karolhof/ASV-PCBs/EmisorASV/documentacion/previsualizaciones/esquema-1.png

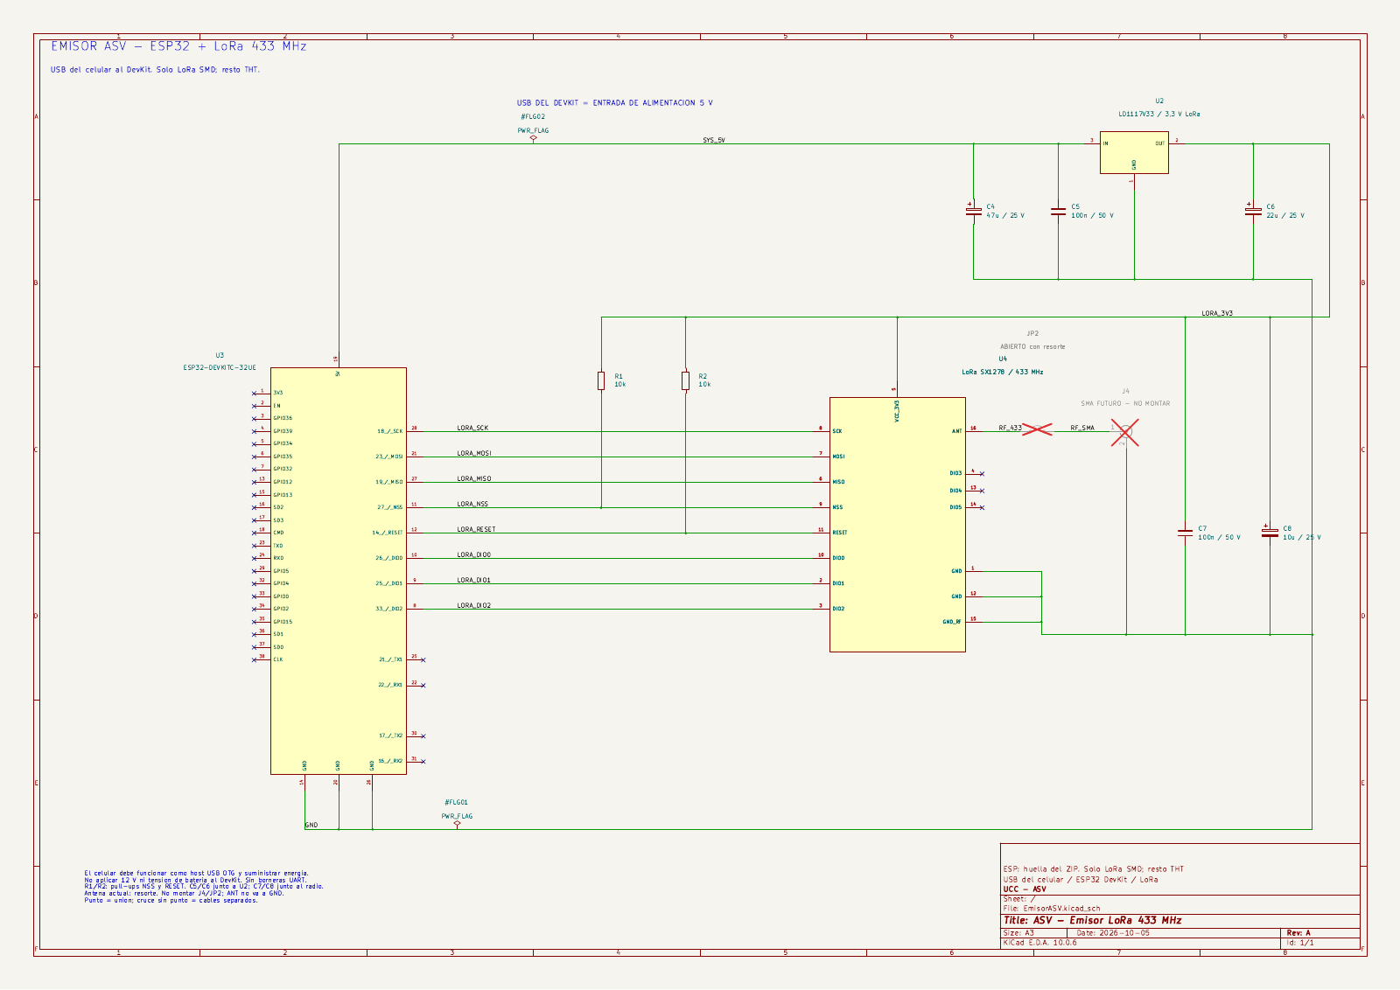
EmisorASV/documentacion/previsualizaciones/esquema-1.png
