karolhof/ASV-PCBs/EmisorASV/documentacion/previsualizaciones/impresion-1.png

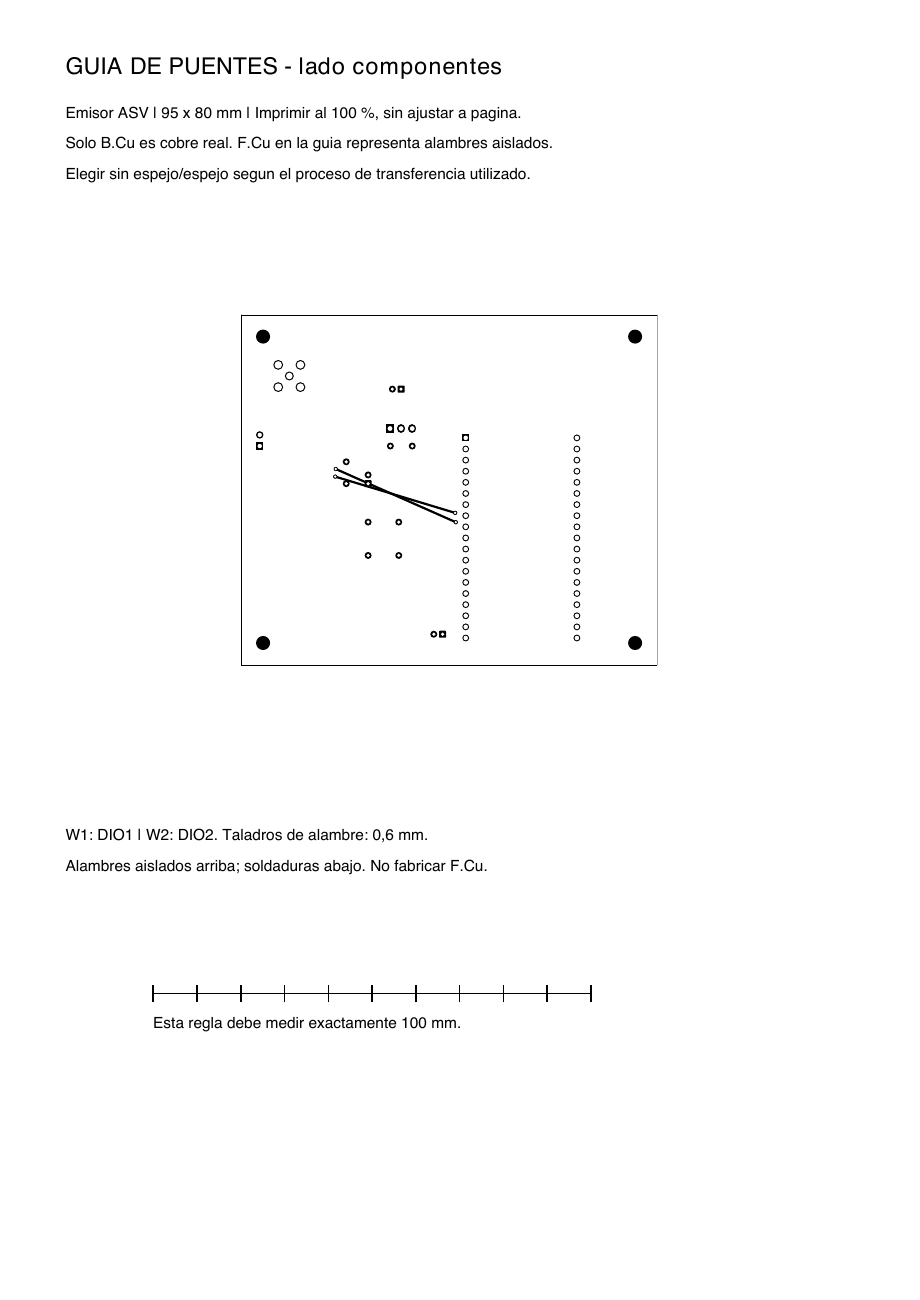
EmisorASV/documentacion/previsualizaciones/impresion-1.png
