karolhof/ASV-PCBs/EmisorASV/documentacion/previsualizaciones/impresion-2.png

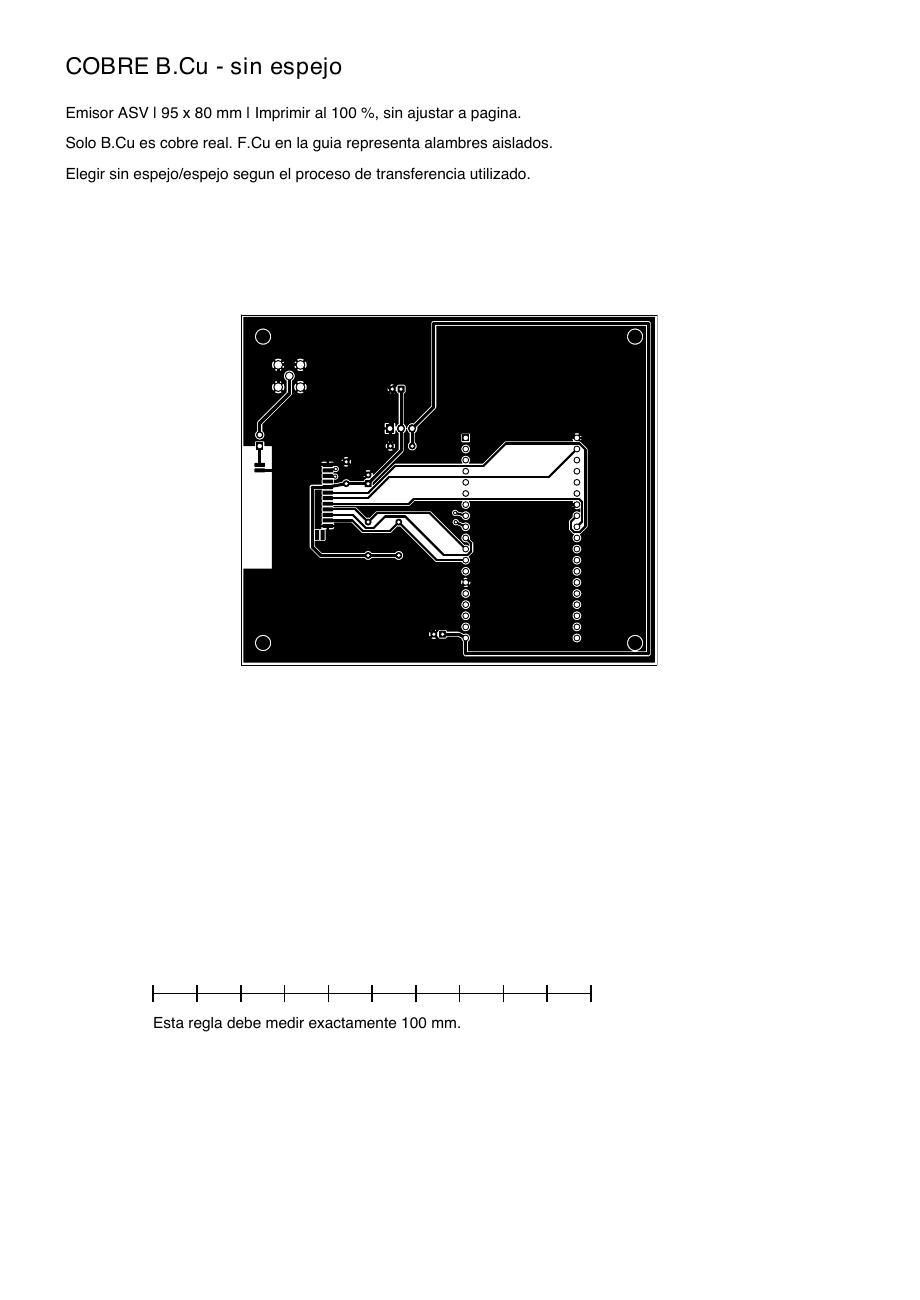
EmisorASV/documentacion/previsualizaciones/impresion-2.png
