karolhof/ASV-PCBs/EmisorASV/documentacion/previsualizaciones/impresion-3.png

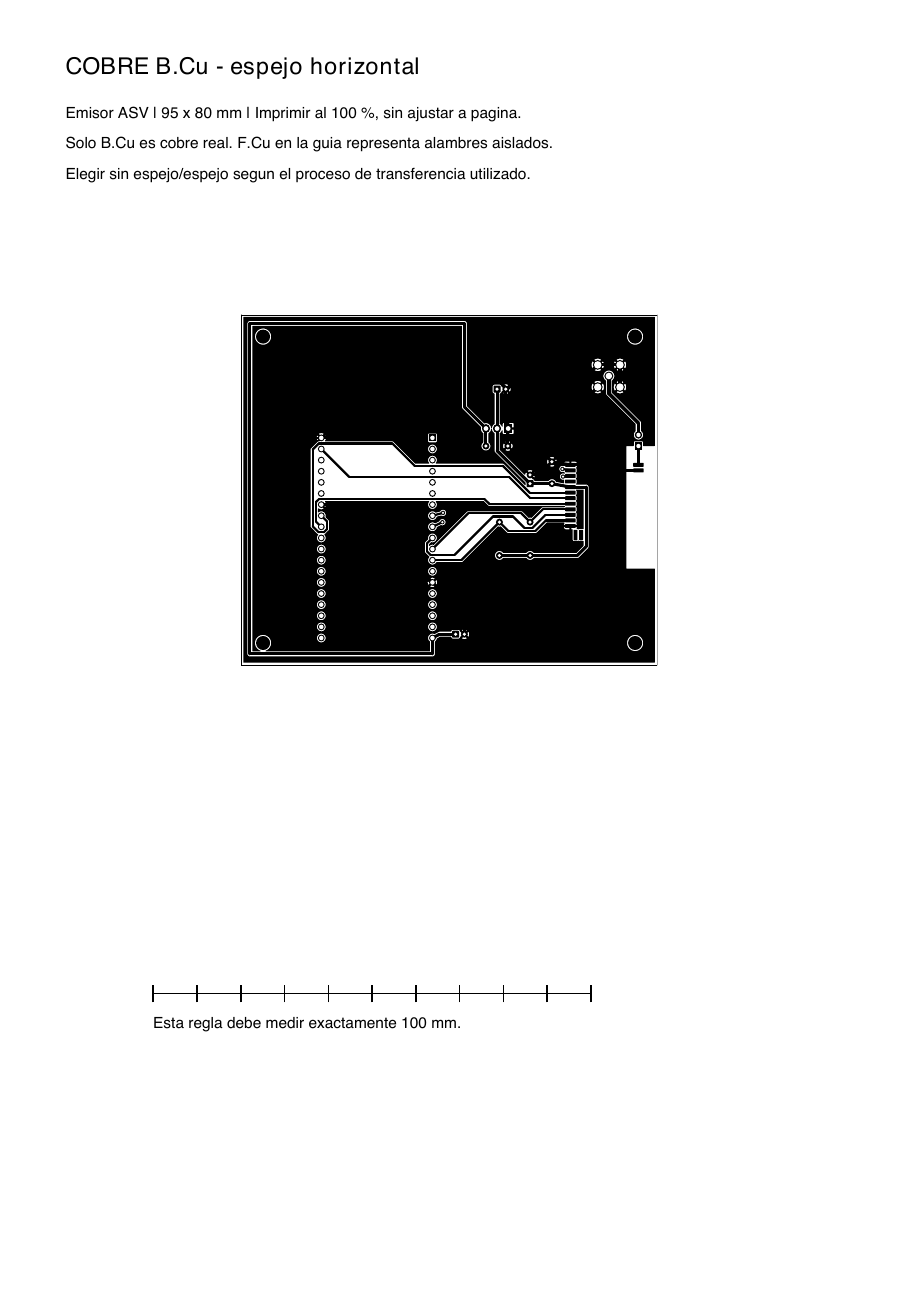
EmisorASV/documentacion/previsualizaciones/impresion-3.png
