karolhof/ASV-PCBs/ReceptorASV/documentacion/previsualizaciones/impresion-1.png

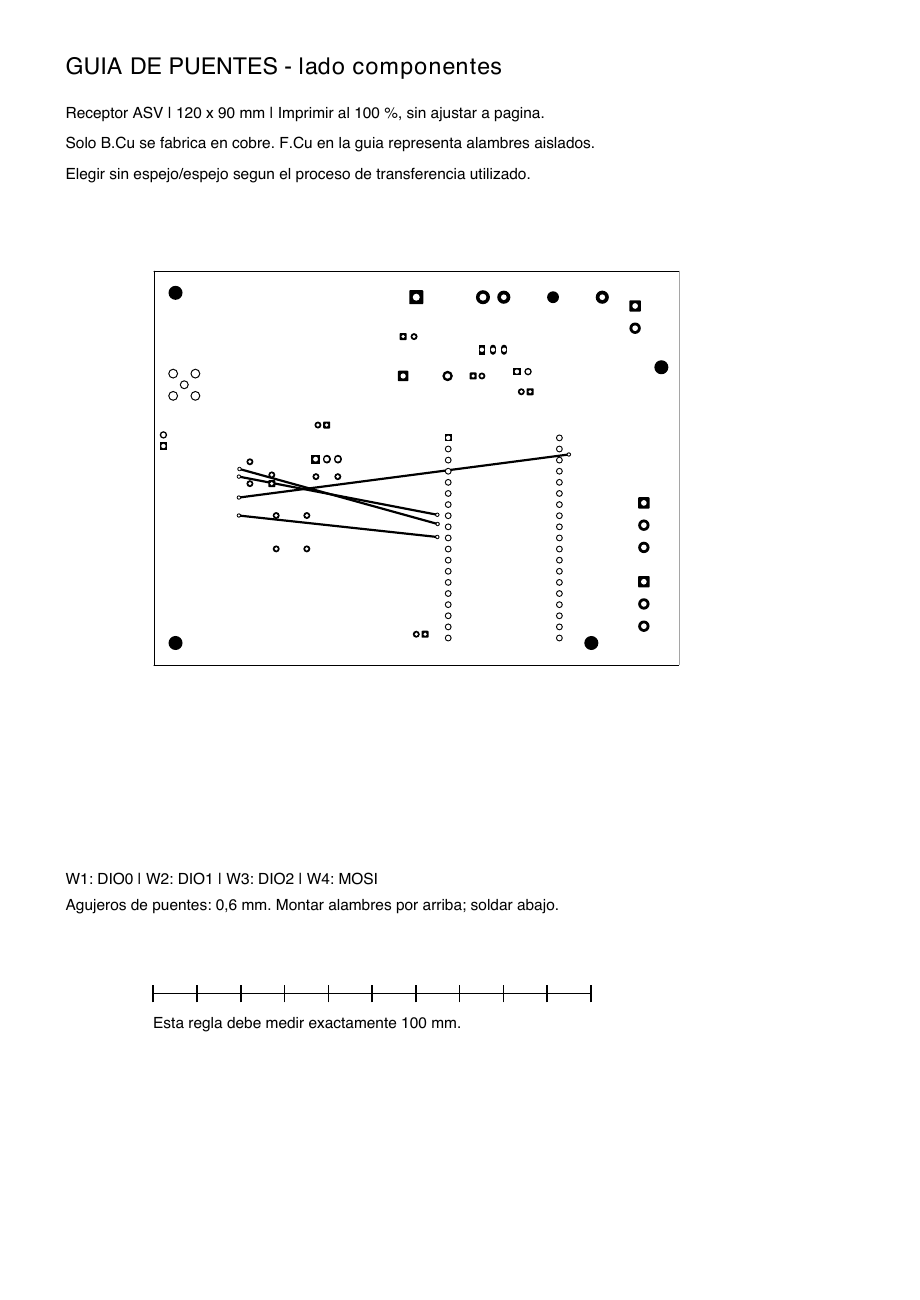
ReceptorASV/documentacion/previsualizaciones/impresion-1.png
