karolhof/ASV-PCBs/ReceptorASV/documentacion/previsualizaciones/impresion-2.png

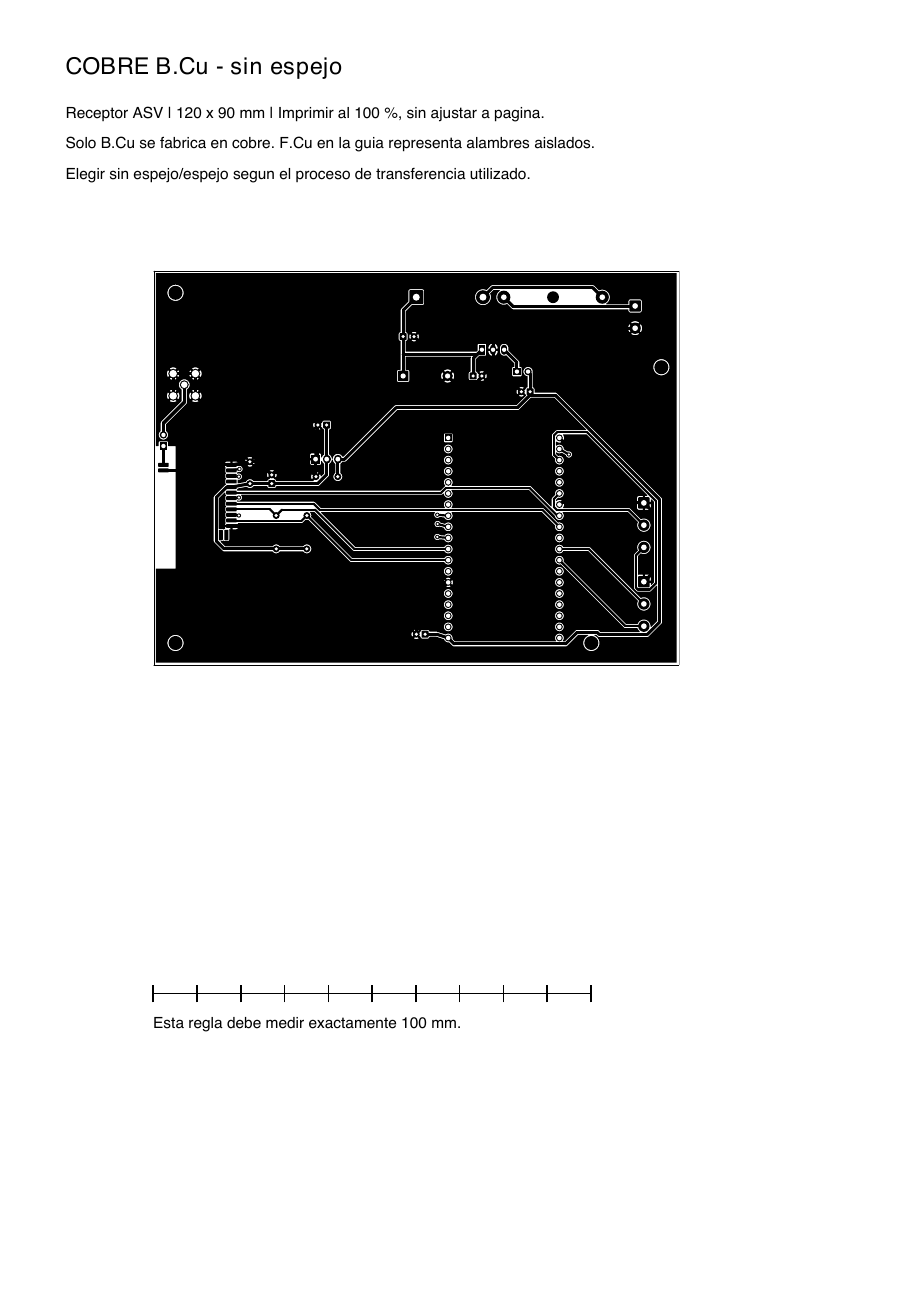
ReceptorASV/documentacion/previsualizaciones/impresion-2.png
