karolhof/ASV-PCBs/EmisorASV/documentacion/BOM.md

# BOM - Emisor ASV

| Referencia | Valor | Huella |
|---|---|---|
| U3 | ESP32-DEVKITC-32UE | ASV_Emisor:ESPRESSIF_ESP32-DEVKITC-32UE |
| U4 | LoRa SX1278 / 433 MHz | ASV_Emisor:XL1278_SMT_16P_16.5x17mm_P1.27mm |
| U2 | LD1117V33 / 3,3 V LoRa | Package_TO_SOT_THT:TO-220-3_Vertical |
| C4 | 47u / 25 V | Capacitor_THT:CP_Radial_D5.0mm_P2.00mm |
| C5 | 100n / 50 V | Capacitor_THT:C_Disc_D5.0mm_W2.5mm_P5.00mm |
| C6 | 22u / 25 V | Capacitor_THT:CP_Radial_D5.0mm_P2.00mm |
| R1 | 10k | Resistor_THT:R_Axial_DIN0207_L6.3mm_D2.5mm_P7.62mm_Horizontal |
| R2 | 10k | Resistor_THT:R_Axial_DIN0207_L6.3mm_D2.5mm_P7.62mm_Horizontal |
| J4 | SMA FUTURO - NO MONTAR | Connector_Coaxial:SMA_Amphenol_132134_Vertical |
| JP2 | ABIERTO con resorte | Connector_PinHeader_2.54mm:PinHeader_1x02_P2.54mm_Vertical |
| C7 | 100n / 50 V | Capacitor_THT:C_Disc_D5.0mm_W2.5mm_P5.00mm |
| C8 | 10u / 25 V | Capacitor_THT:CP_Radial_D5.0mm_P2.00mm |

J4/JP2 sin montar. Agregar W1/W2, dos zócalos 1×19 y cable/adaptador OTG; ver lista agrupada de materiales.
