karolhof/ASV-PCBs/EmisorASV/referencias/ESP32-DEVKITC-32UE/ESP32-DEVKITC-32UE.step

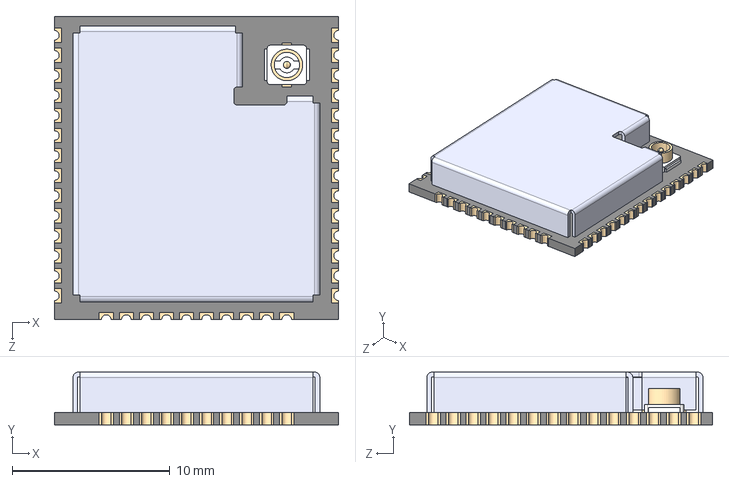
[picture p7: CAD file, 2026-10-06]
EmisorASV/referencias/ESP32-DEVKITC-32UE/ESP32-DEVKITC-32UE.step
18.0 x 3.35 x 19.2 mm
