karolhof/ASV-PCBs/EmisorASV/documentacion/previsualizaciones/montaje-1.png

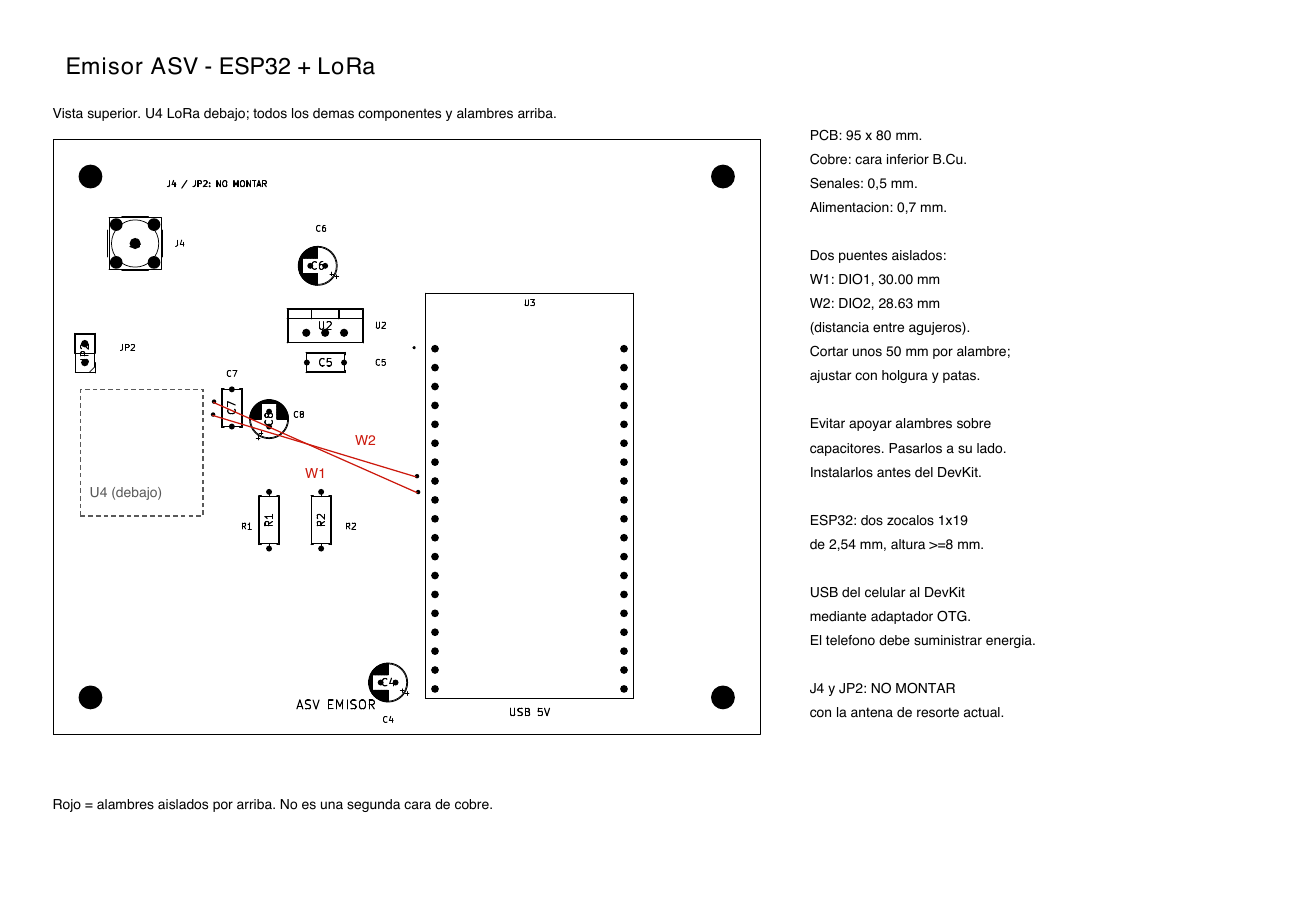
EmisorASV/documentacion/previsualizaciones/montaje-1.png
