karolhof/ASV-PCBs/EmisorASV/documentacion/previsualizaciones/montaje-2.png

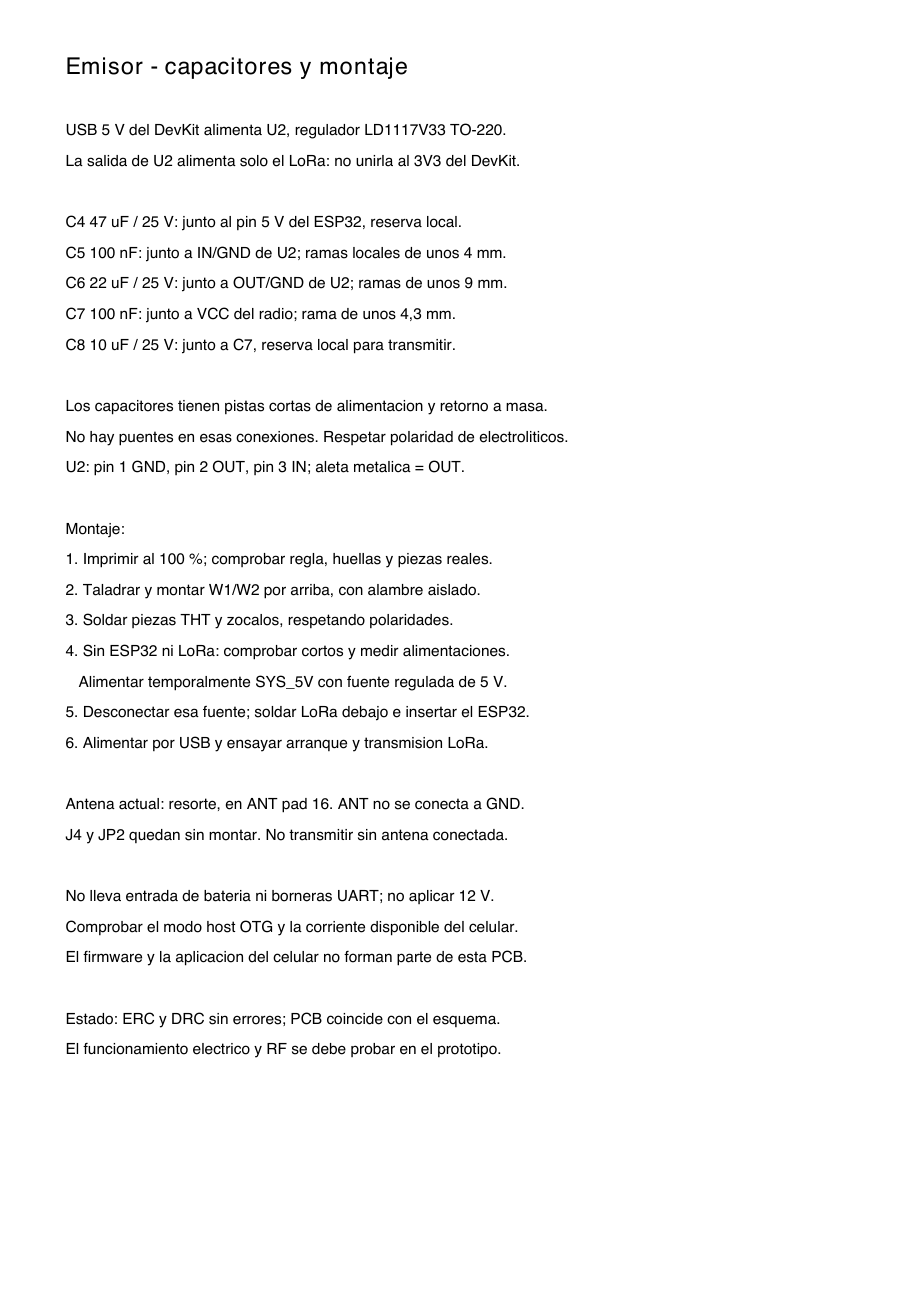
EmisorASV/documentacion/previsualizaciones/montaje-2.png
