karolhof/ASV-PCBs/ReceptorASV/documentacion/previsualizaciones/montaje-1.png

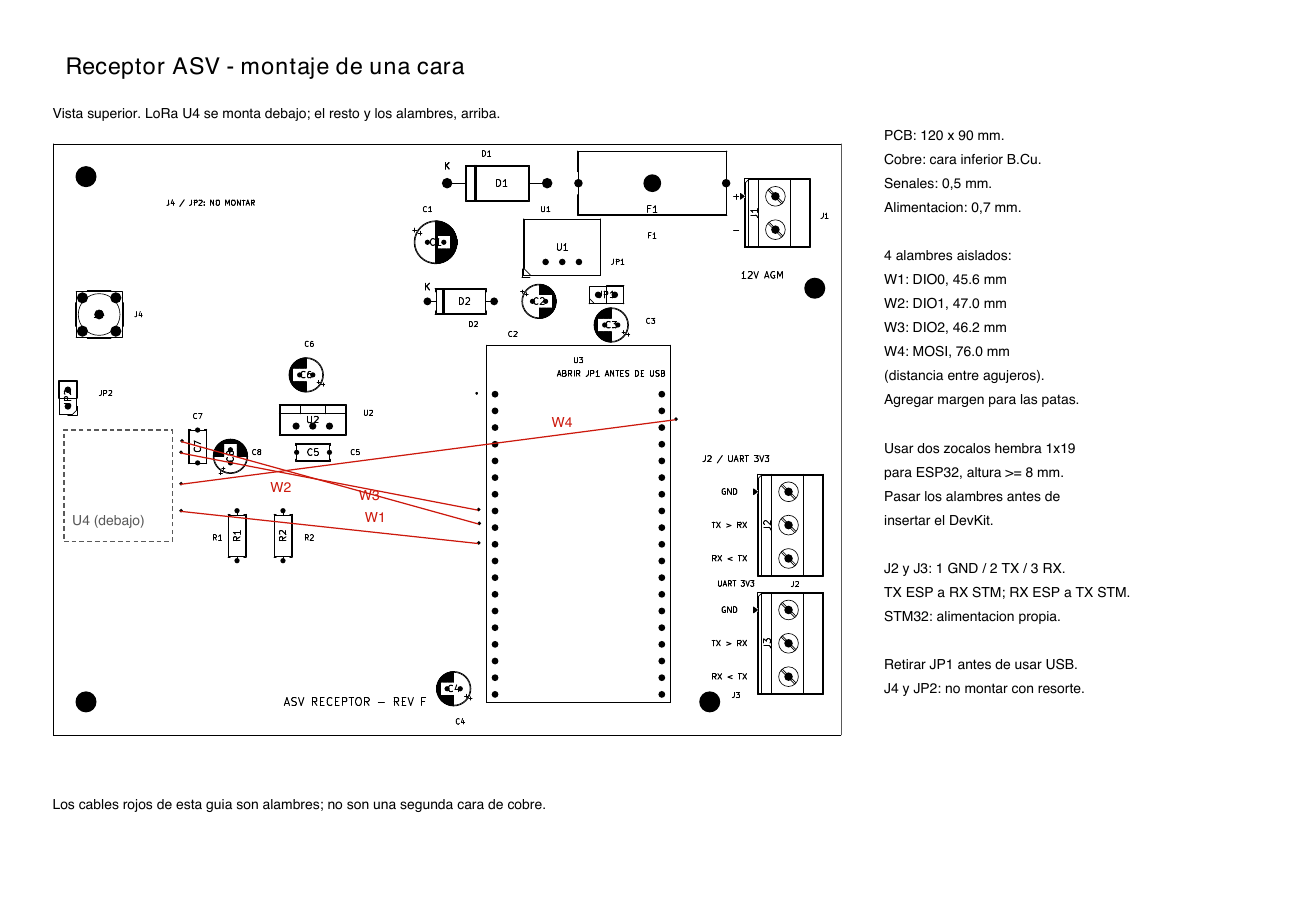
ReceptorASV/documentacion/previsualizaciones/montaje-1.png
