karolhof/ASV-PCBs/ReceptorASV/documentacion/previsualizaciones/montaje-2.png

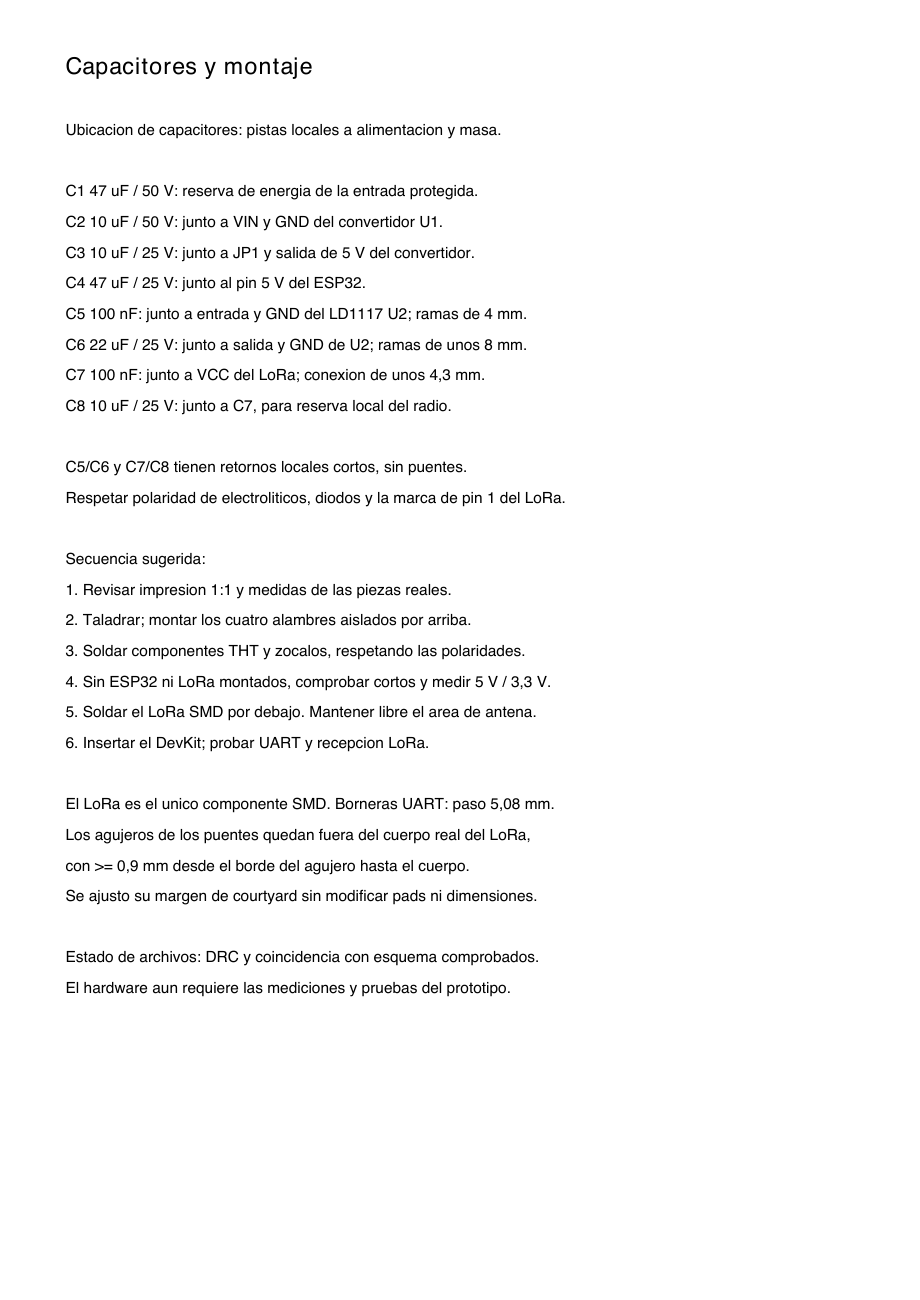
ReceptorASV/documentacion/previsualizaciones/montaje-2.png
