karolhof/ASV-PCBs/ReceptorASV/ReceptorASV.pdf

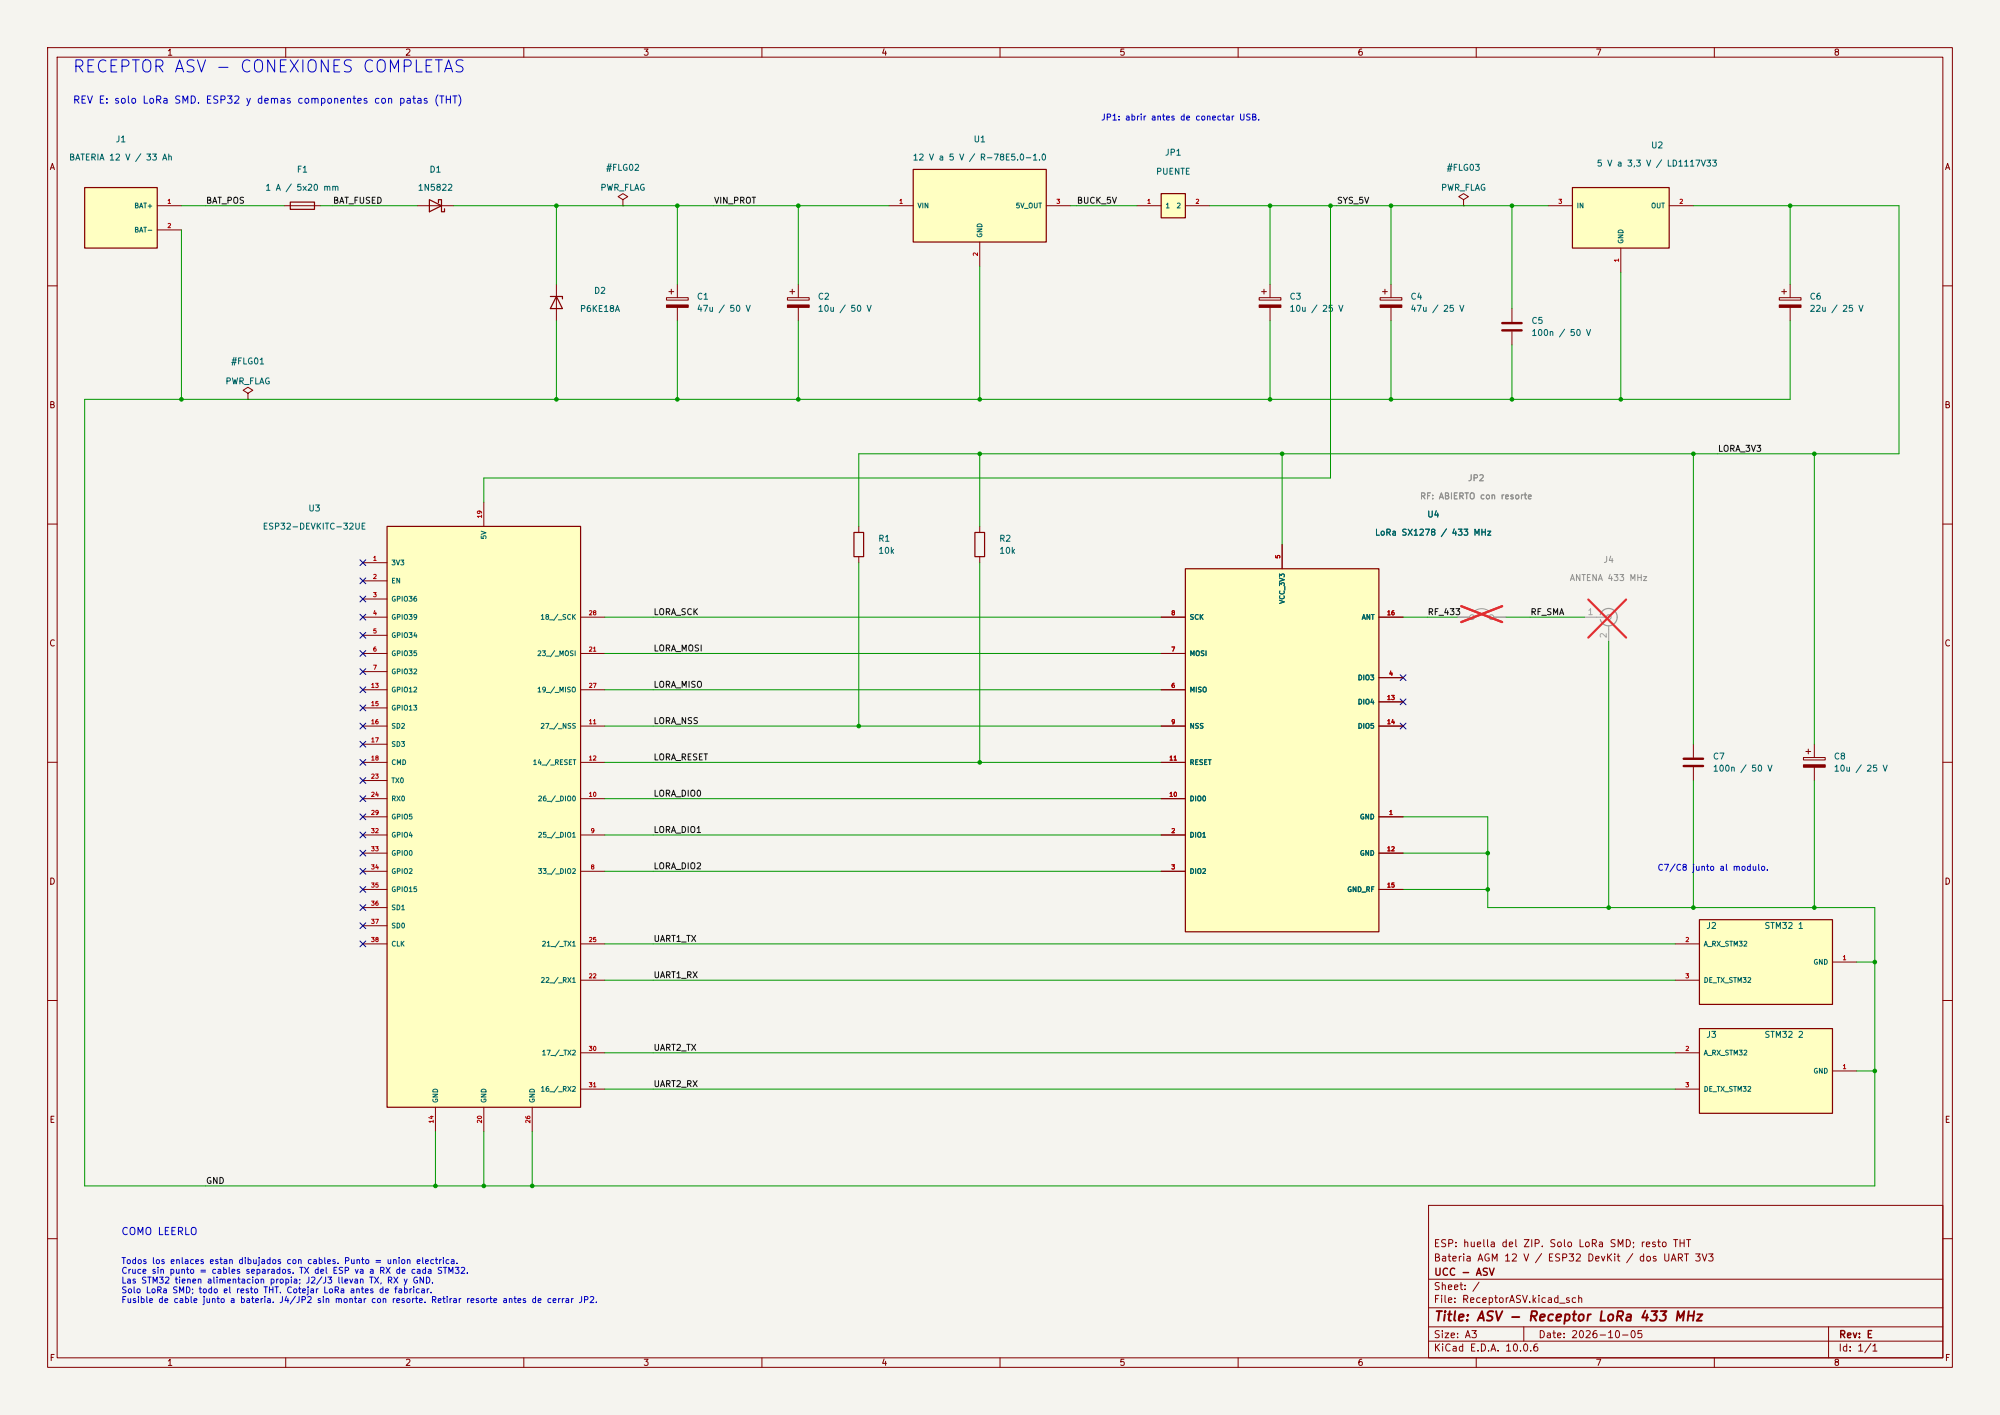
[picture p14: page 1]

RECEPTOR ASV - CONEXIONES COMPLETAS

REV E: solo LoRa SMD. ESP32 y demas componentes con patas (THT)

5 MISO 6 MOSI 7 SCK 8 NSS 9 DIO0 10 RESET 11 GND 12 DIO4 13 DIO5 14 GND_RF 15 ANT 16 JP2 RF: ABIERTO con resorte

JP2 RF: ABIERTO con resorte

5 MISO 6 MOSI 7 SCK 8 NSS 9 DIO0 10 RESET 11 GND 12 DIO4 13 DIO5 14 GND_RF 15 ANT 16 U4

ESP: huella del ZIP. Solo LoRa SMD; resto THT
Bateria AGM 12 V / ESP32 DevKit / dos UART 3V3
UCC - ASV
Sheet: /
File: ReceptorASV.kicad_sch
Title: ASV - Receptor LoRa 433 MHz

Todos los enlaces estan dibujados con cables. Punto = union electrica. Cruce sin punto = cables separados. TX del ESP va a RX de cada STM32. Las STM32 tienen alimentacion propia; J2/J3 llevan TX, RX y GND. Solo LoRa SMD; todo el resto THT. Cotejar LoRa antes de fabricar. Fusible de cable junto a bateria. J4/JP2 sin montar con resorte. Retirar resorte antes de cerrar JP2.

Size: A3 | Rev: E | F Date: 2026-10-05
KiCad E.D.A. 10.0.6 | Id: 1/1
