karolhof/ASV-PCBs/EmisorASV/documentacion/EmisorASV.pdf

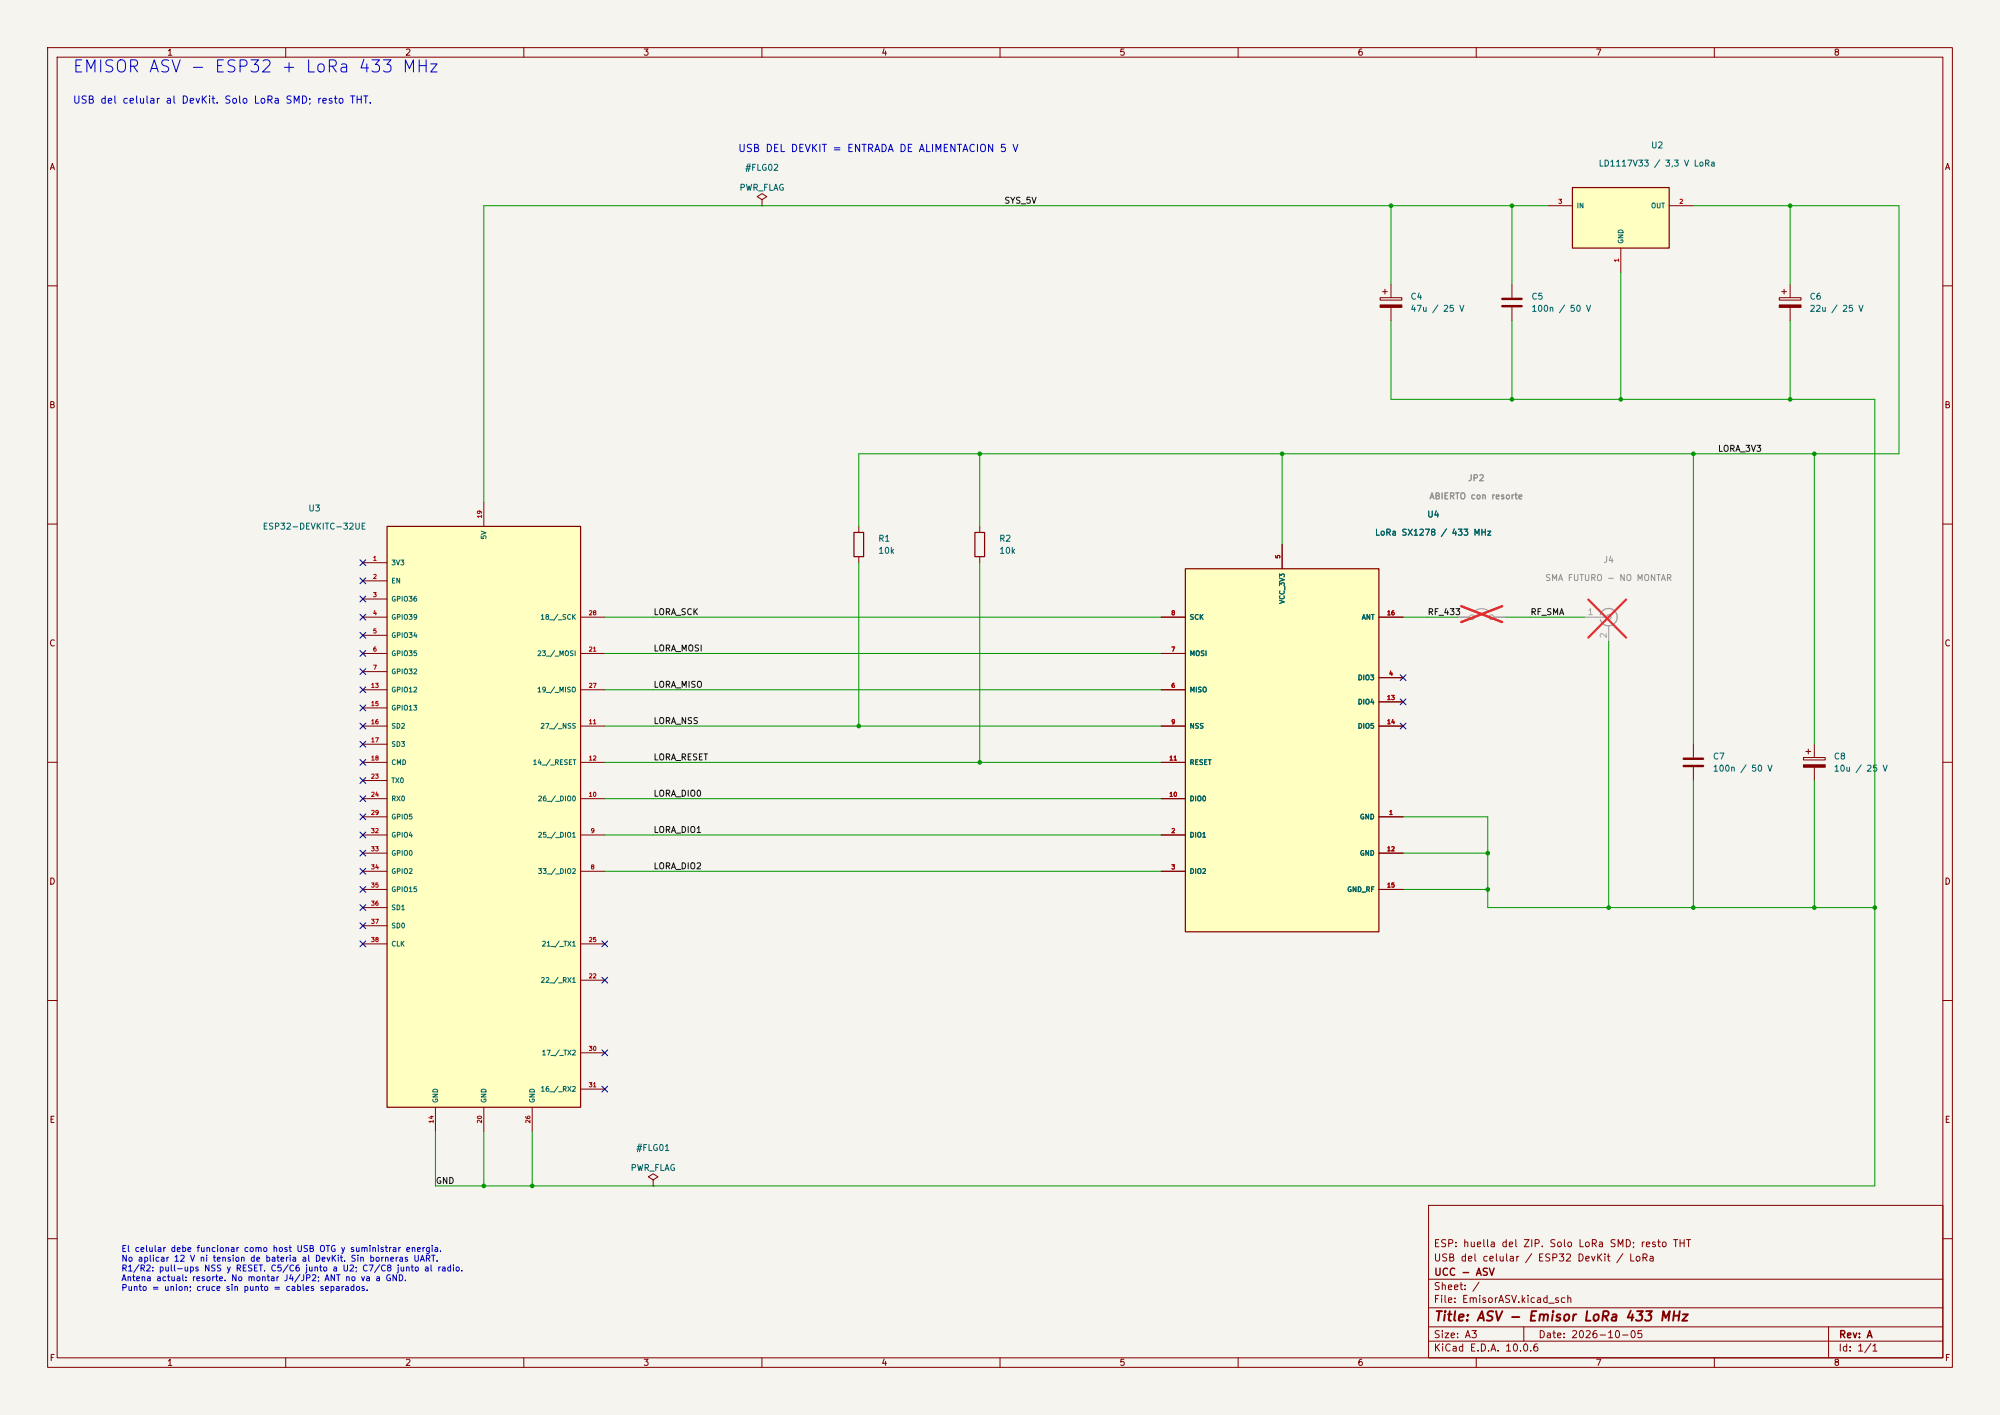
[picture p15: page 1]

EMISOR ASV - ESP32 + LoRa 433 MHz

USB del celular al DevKit. Solo LoRa SMD; resto THT.

USB DEL DEVKIT = ENTRADA DE ALIMENTACION 5 V

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

SMA FUTURO - NO MONTAR

ESP: huella del ZIP. Solo LoRa SMD; resto THT
USB del celular / ESP32 DevKit / LoRa
UCC - ASV
Sheet: /
File: EmisorASV.kicad_sch
Title: ASV - Emisor LoRa 433 MHz

El celular debe funcionar como host USB OTG y suministrar energia. No aplicar 12 V ni tension de bateria al DevKit. Sin borneras UART. R1/R2: pull-ups NSS y RESET. C5/C6 junto a U2; C7/C8 junto al radio. Antena actual: resorte. No montar J4/JP2; ANT no va a GND. Punto = union; cruce sin punto = cables separados.

Size: A3 | Rev: A | F Date: 2026-10-05
KiCad E.D.A. 10.0.6 | Id: 1/1
