karolhof/ASV-PCBs/EmisorASV/documentacion/PCB_Impresion_1a1.pdf

## GUIA DE PUENTES - lado componentes

Emisor ASV | 95 x 80 mm | Imprimir al 100 %, sin ajustar a pagina.
Solo B.Cu es cobre real. F.Cu en la guia representa alambres aislados. Elegir sin espejo/espejo segun el proceso de transferencia utilizado.

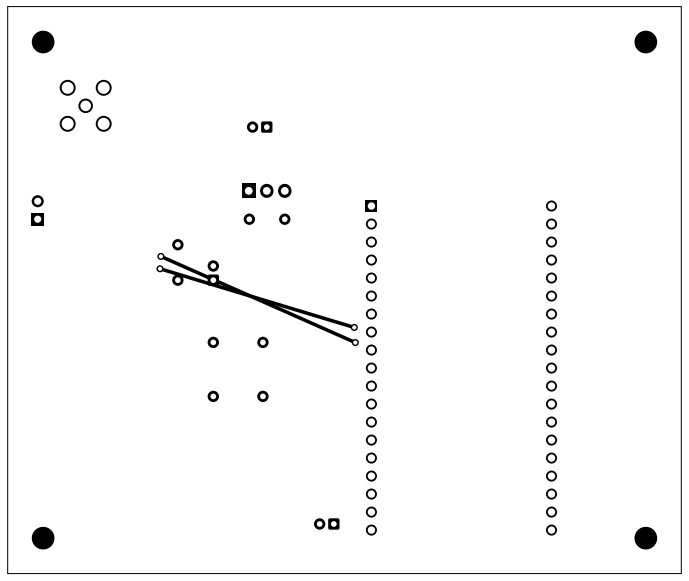
[picture p16: figure]

Esta regla debe medir exactamente 100 mm.

W1: DIO1 | W2: DIO2. Taladros de alambre: 0,6 mm.
Alambres aislados arriba; soldaduras abajo. No fabricar F.Cu.

## COBRE B.Cu - sin espejo

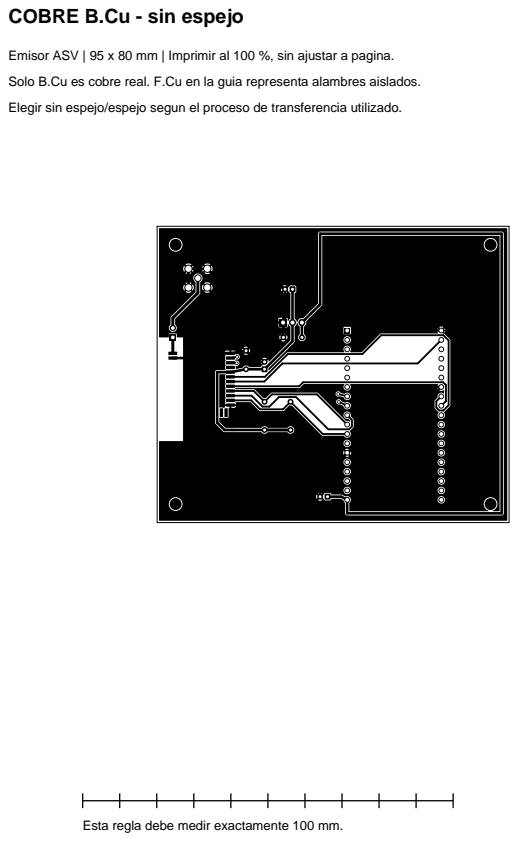
[picture p17: page 2]
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

Esta regla debe medir exactamente 100 mm.

## COBRE B.Cu - espejo horizontal

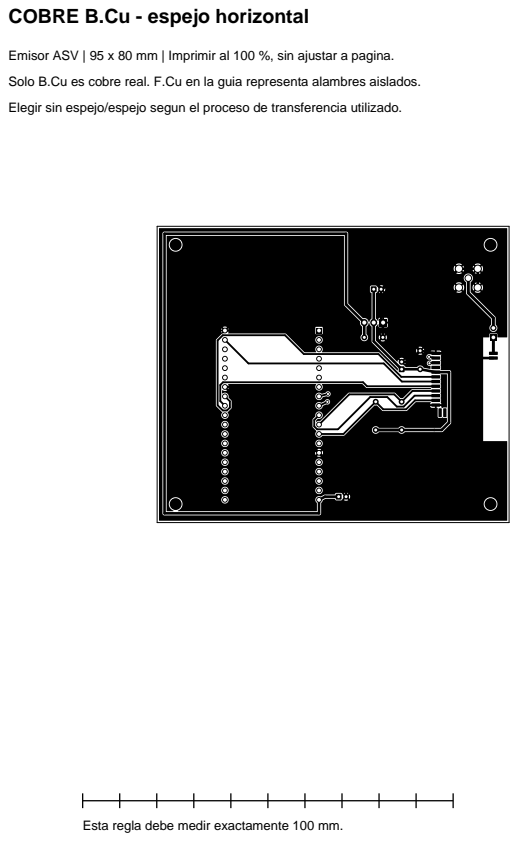
[picture p18: page 3]
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

Esta regla debe medir exactamente 100 mm.
