karolhof/ASV-PCBs/ReceptorASV/documentacion/Huella_LoRa_XL1278_SMD.pdf

# LoRa XL1278-SMT

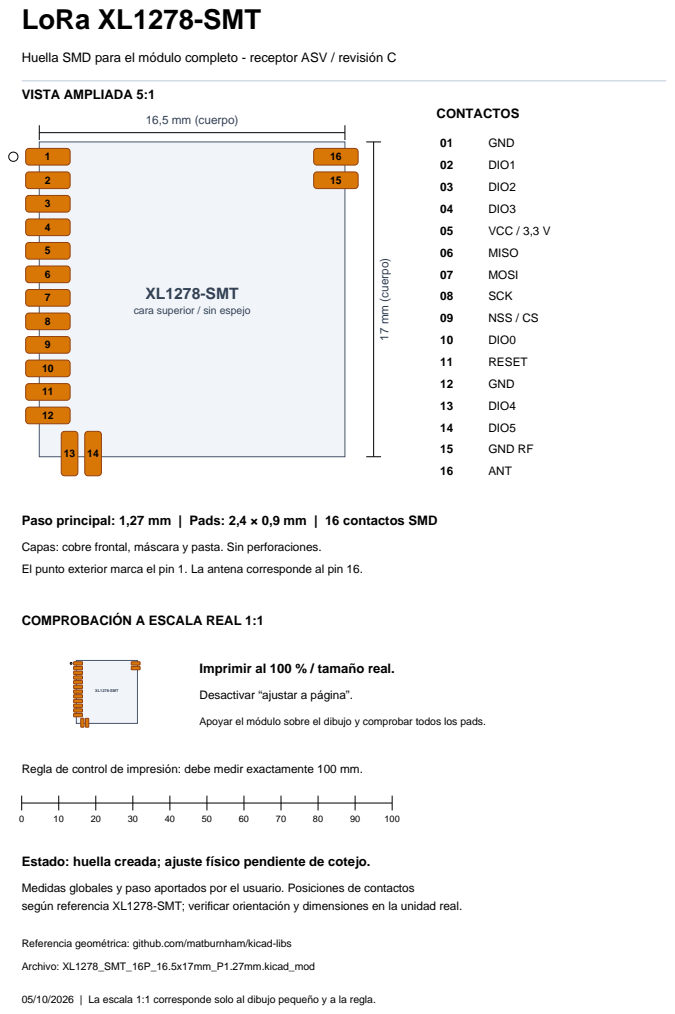
[picture p19: page 1]
VISTA AMPLIADA 5:1; 16,5 mm (cuerpo); 17 mm (cuerpo); CONTACTOS; 01 GND; 02 DIO1; 03 DIO2; 04 DIO3; 05 VCC / 3,3 V; 06 MISO; 07 MOSI; 08 SCK; 09 NSS / CS; 10 DIO0; 11 RESET; 12 GND; 13 DIO4; 14 DIO5; 15 GND RF; 16 ANT; XL1278-SMT

Huella SMD para el módulo completo - receptor ASV / revisión C

XL1278-SMT
cara superior / sin espejo

Paso principal: 1,27 mm | Pads: 2,4 × 0,9 mm | 16 contactos SMD

Capas: cobre frontal, máscara y pasta. Sin perforaciones.
El punto exterior marca el pin 1. La antena corresponde al pin 16.

COMPROBACIÓN A ESCALA REAL 1:1

Imprimir al 100 % / tamaño real.

Desactivar “ajustar a página”.

Apoyar el módulo sobre el dibujo y comprobar todos los pads.

Regla de control de impresión: debe medir exactamente 100 mm.

Estado: huella creada; ajuste físico pendiente de cotejo.

Medidas globales y paso aportados por el usuario. Posiciones de contactos
según referencia XL1278-SMT; verificar orientación y dimensiones en la unidad real.

Referencia geométrica: github.com/matburnham/kicad-libs
Archivo: XL1278_SMT_16P_16.5x17mm_P1.27mm.kicad_mod

05/10/2026 | La escala 1:1 corresponde solo al dibujo pequeño y a la regla.
