karolhof/ASV-PCBs/ReceptorASV/documentacion/PCB_Impresion_1a1.pdf

## GUIA DE PUENTES - lado componentes

Receptor ASV | 120 x 90 mm | Imprimir al 100 %, sin ajustar a pagina.
Solo B.Cu se fabrica en cobre. F.Cu en la guia representa alambres aislados. Elegir sin espejo/espejo segun el proceso de transferencia utilizado.

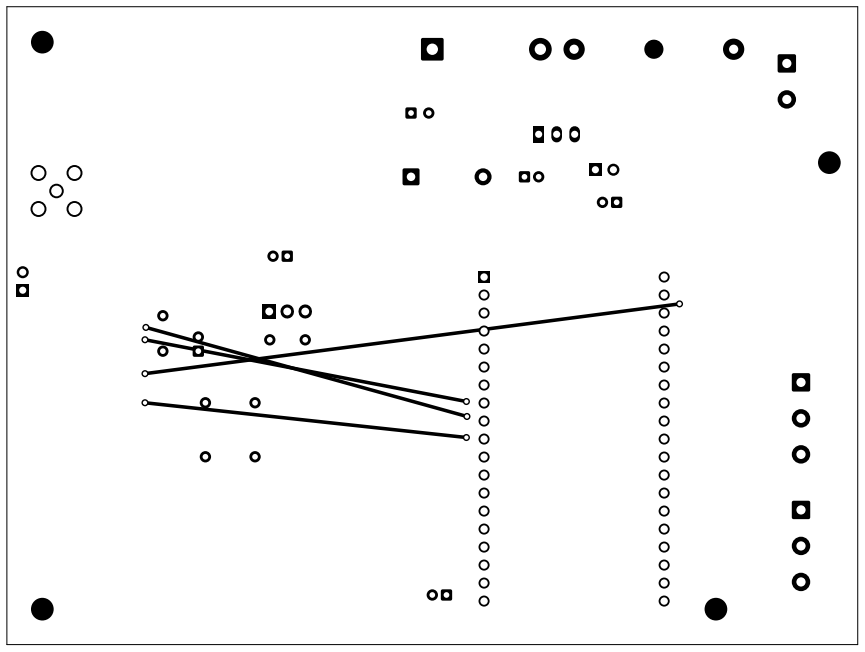
[picture p20: figure]

Esta regla debe medir exactamente 100 mm.

W1: DIO0 | W2: DIO1 | W3: DIO2 | W4: MOSI
Agujeros de puentes: 0,6 mm. Montar alambres por arriba; soldar abajo.

## COBRE B.Cu - sin espejo

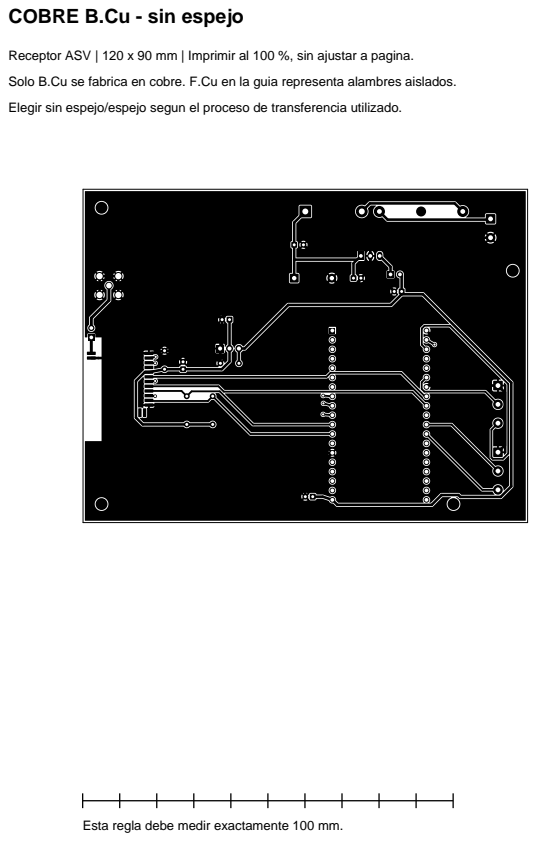
[picture p21: page 2]
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

Esta regla debe medir exactamente 100 mm.

## COBRE B.Cu - espejo horizontal

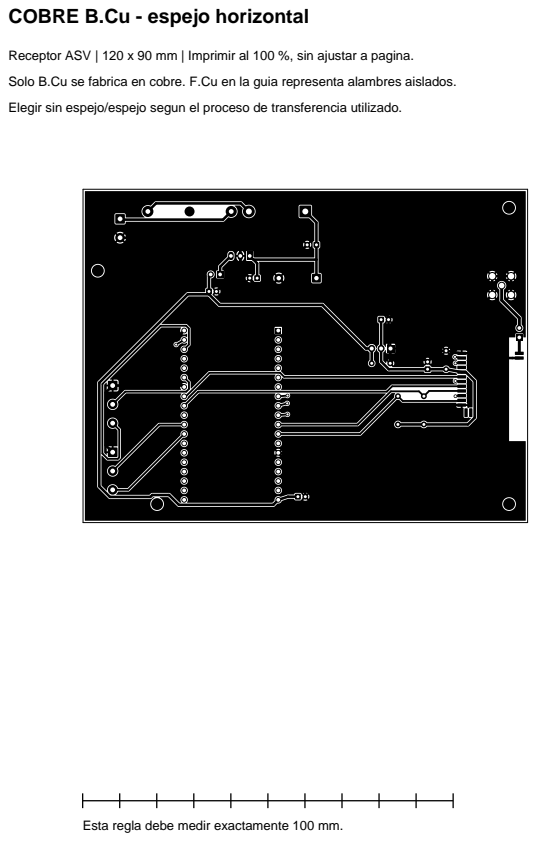
[picture p22: page 3]
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

Esta regla debe medir exactamente 100 mm.
