karolhof/ASV-PCBs/(list of files, drawings)

Other design files:
EmisorASV/documentacion/EmisorASV.dsn
EmisorASV/documentacion/EmisorASV_una_cara.dsn
ReceptorASV/documentacion/ReceptorASV.dsn
ReceptorASV/documentacion/ReceptorASV_una_cara.dsn
