karolhof/ASV-PCBs/EmisorASV/EmisorASV.kicad_pcb

## KiCad design EmisorASV/EmisorASV.kicad_pcb (2026-10-07)

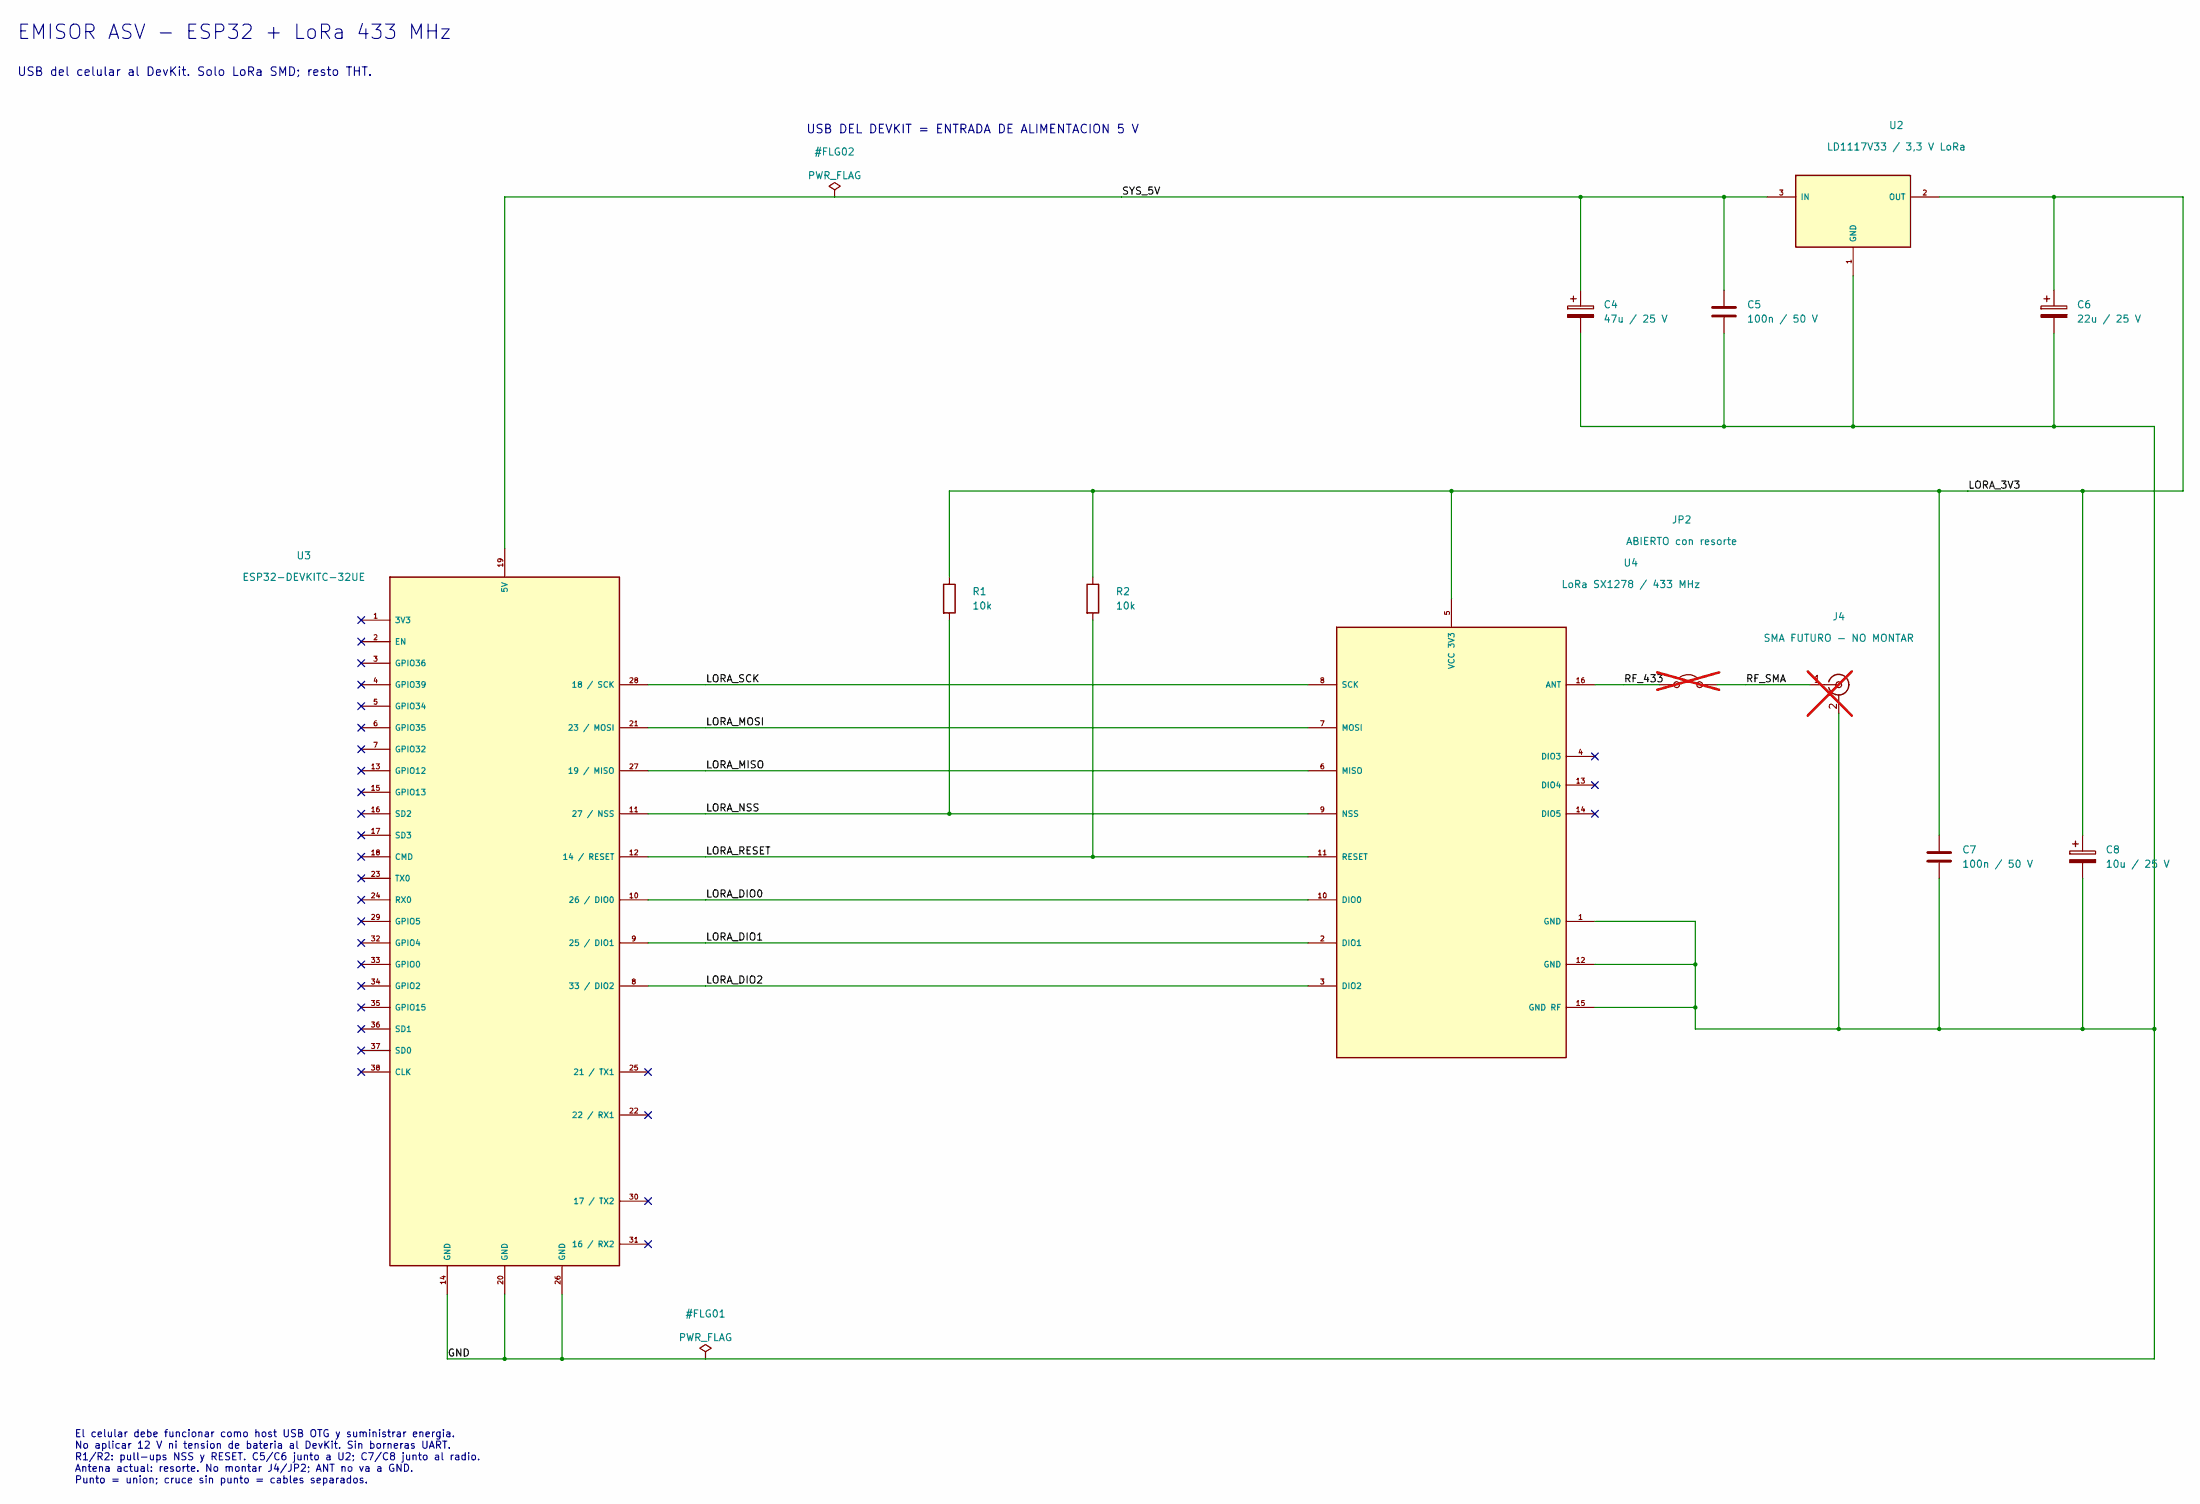
[picture p23: schematic EmisorASV.kicad_sch, ASV - Emisor LoRa 433 MHz]

Parts:
C4: 47u / 25 V; CP_Radial_D5.0mm_P2.00mm
C5, C7: 100n / 50 V; C_Disc_D5.0mm_W2.5mm_P5.00mm
C6: 22u / 25 V; CP_Radial_D5.0mm_P2.00mm
C8: 10u / 25 V; CP_Radial_D5.0mm_P2.00mm
J4: SMA FUTURO - NO MONTAR; SMA_Amphenol_132134_Vertical; not fitted
JP2: ABIERTO con resorte; PinHeader_1x02_P2.54mm_Vertical; not fitted
R1, R2: 10k; R_Axial_DIN0207_L6.3mm_D2.5mm_P7.62mm_Horizontal
U2: LD1117V33 / 3,3 V LoRa; TO-220-3_Vertical
U3: ESP32-DEVKITC-32UE; ESPRESSIF_ESP32-DEVKITC-32UE
U4: LoRa SX1278 / 433 MHz; XL1278_SMT_16P_16.5x17mm_P1.27mm

Connections:
/GND: C4.2, C5.2, C6.2, C7.2, C8.2, J4.2 (Ext), U2.1 (GND), U3.14 (GND), U3.20 (GND), U3.26 (GND), U4.1 (GND), U4.12 (GND), U4.15 (GND RF)
/LORA_3V3: C6.1, C7.1, C8.1, R1.1, R2.1, U2.2 (OUT), U4.5 (VCC 3V3)
/LORA_DIO0: U3.10 (26 / DIO0), U4.10 (DIO0)
/LORA_DIO1: U3.9 (25 / DIO1), U4.2 (DIO1); also elsewhere on the board
/LORA_DIO2: U3.8 (33 / DIO2), U4.3 (DIO2); also elsewhere on the board
/LORA_MISO: U3.27 (19 / MISO), U4.6 (MISO)
/LORA_MOSI: U3.21 (23 / MOSI), U4.7 (MOSI)
/LORA_NSS: R1.2, U3.11 (27 / NSS), U4.9 (NSS)
/LORA_RESET: R2.2, U3.12 (14 / RESET), U4.11 (RESET)
/LORA_SCK: U3.28 (18 / SCK), U4.8 (SCK)
/RF_433: JP2.1 (A), U4.16 (ANT)
/RF_SMA: J4.1 (In), JP2.2 (B)
/SYS_5V: C4.1, C5.1, U2.3 (IN), U3.19 (5V)

Notes on the sheet:
EMISOR ASV - ESP32 + LoRa 433 MHz
USB del celular al DevKit. Solo LoRa SMD; resto THT.
USB DEL DEVKIT = ENTRADA DE ALIMENTACION 5 V
El celular debe funcionar como host USB OTG y suministrar energia. No aplicar 12 V ni tension de bateria al DevKit. Sin borneras UART. R1/R2: pull-ups NSS y RESET. C5/C6 junto a U2; C7/C8 junto al radio. Antena actual: resorte. No montar J4/JP2; ANT no va a GND. Punto = union; cruce sin punto = cab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

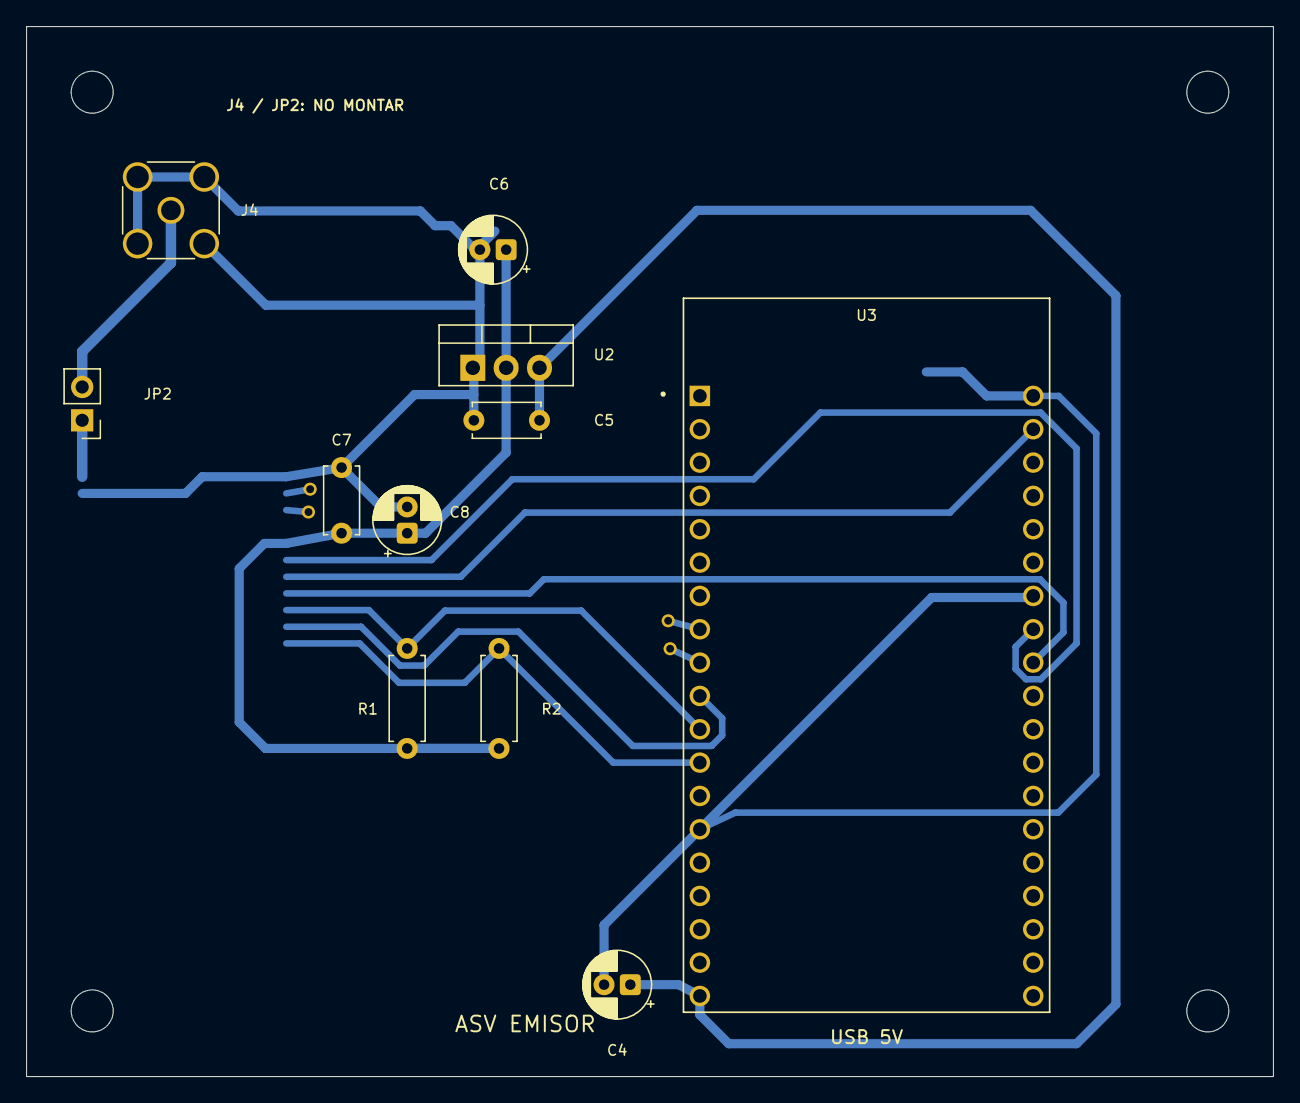
[picture p24: board EmisorASV.kicad_pcb from above]

Board: 2 copper layers, 95.0 x 80.0 mm, 18 parts (1 on the bottom side), 13 nets.

Other parts of the board:
H1, H2, H3, H4: M3; MountingHole_3.2mm_M3
W1: ALAMBRE AISLADO; Wire_Jumper_W1_30_00mm
W2: ALAMBRE AISLADO; Wire_Jumper_W2_28_63mm

Their connections:
/LORA_DIO1: W1.1; also elsewhere on the board
/LORA_DIO2: W2.1; also elsewhere on the board
