karolhof/ASV-PCBs/(commit log)

2026-10-06 Agrega diseños del emisor y receptor LoRa ASV con documentación y fabricación
    [ESP32-DEVKITC-32UE.step, EmisorASV.dsn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]
2026-10-07 emisor creo q esta listo, vr el tema usb c
    [EmisorASV.kicad_pcb]
